bseishen/wordClock/README.md

wordClock
==========

This repository contains my own take on the word clock. Insperation came from an instructable(http://www.instructables.com/id/Sleek-word-clock/). The hardware drives a matrix of 13x8 led's. Uses mosfets for the rows and a TLC5940 for the column driver.
