bseishen/wordClock/CNC/README.md

# Compiling
Run `make` to automatically compile and export all of the src files as stl files.  Make sure to update the path to your openscad installation.
