bseishen/wordClock/CNC/output/ledBoard.stl

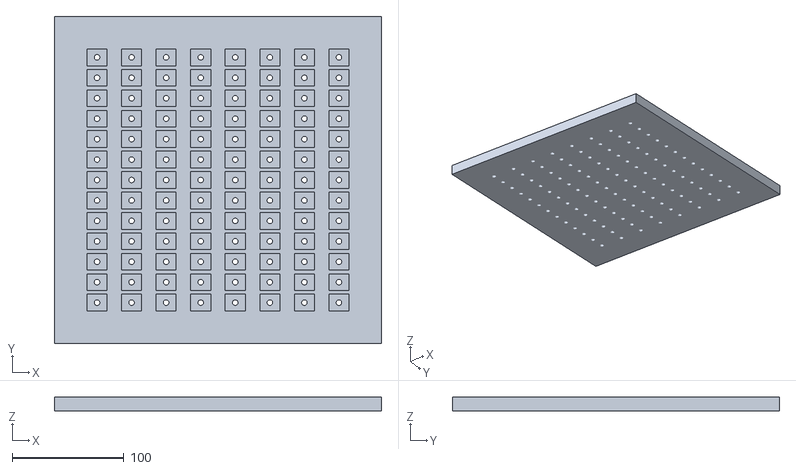
[picture p1: CAD file, 2013-11-08]
CNC/output/ledBoard.stl
292.1 x 292.1 x 12.7
