bseishen/wordClock/CNC/src/ouputDXF.dxf

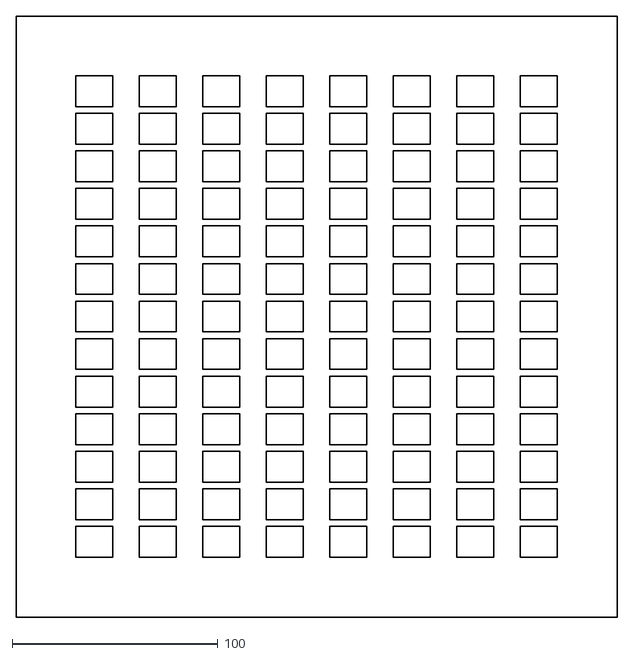
[picture p2: CAD file, 2013-11-08]
CNC/src/ouputDXF.dxf
292.1 x 292.1
