bseishen/wordClock/CNC/configuration.scad

/*
	Authors: Ben Eishen (bseishen)
			  Kit (slav3_kitten)
			  Daniel Hess (dan9186)
	Git Hub:  https://github.com/bseishen/wordClock
*/

//****** Variables to Adjust ******//
//Board Values
BoardWidth = 292.1;
BoardLength = 292.1;
BoardThickness = 12.7;

//Light Values
LightCols = 8;
LightRows = 13;
LightTrim = 29;

//Light Cavity Values
CavityWidth = 18;
CavityLength = 15;
CavityBottomThickness = 4;

//LED Size
LEDRadius = 2.5;
