bseishen/wordClock/hardware/Word Clock.sch

## KiCad design hardware/Word Clock.sch (2013-11-05, an earlier design)

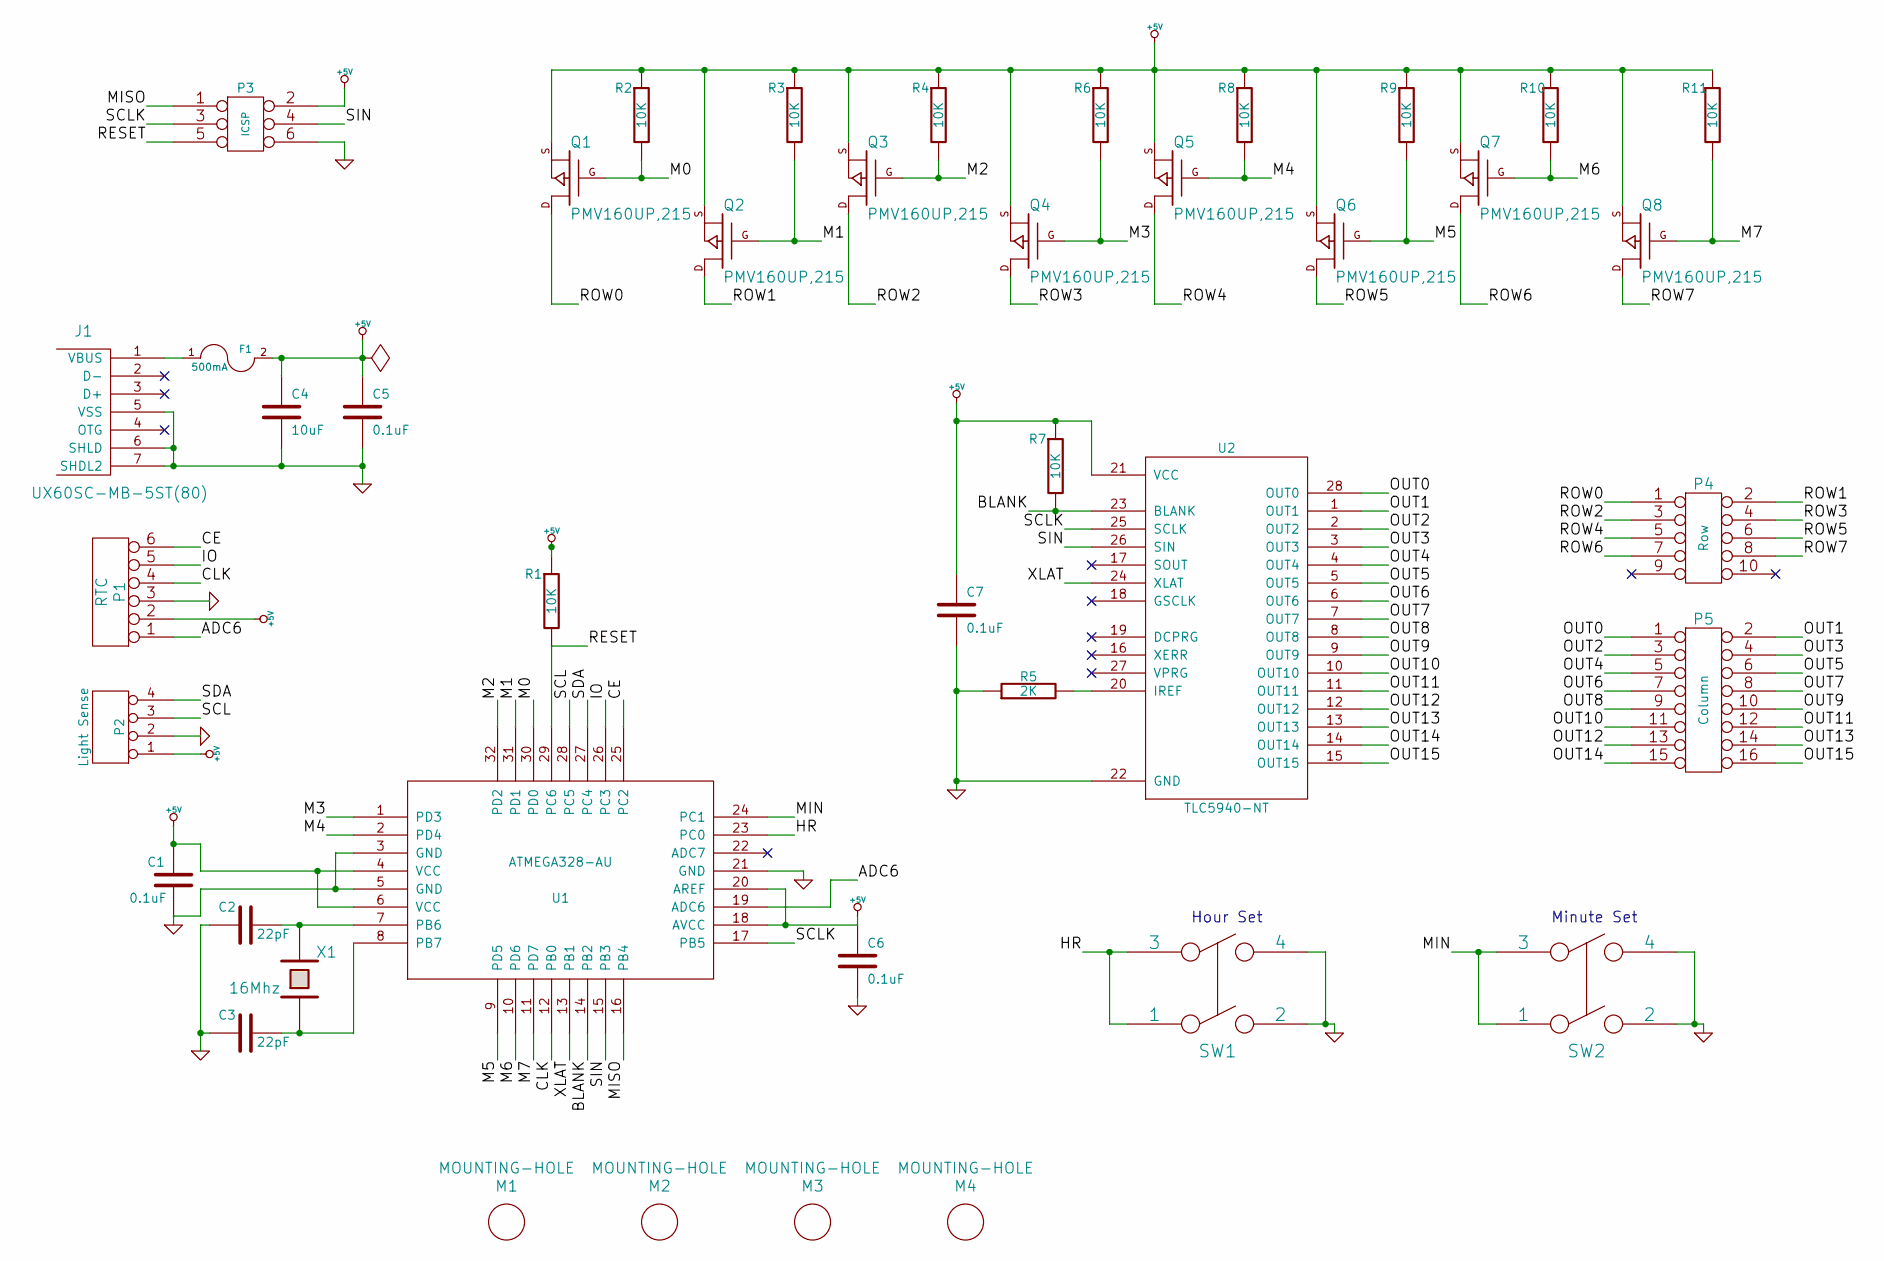
[picture p3: schematic Word Clock.sch]

Parts:
C1, C5, C6, C7: 0.1uF
C2, C3: 22pF
C4: 10uF
F1: 500mA
J1: UX60SC-MB-5ST(80)
M1, M2, M3, M4: MOUNTING-HOLE
P1: RTC
P2: Light Sense
P3: ICSP
P4: Row
P5: Column
Q1, Q2, Q3, Q4, Q5, Q6, Q7, Q8: PMV160UP,215
R1, R2, R3, R4, R6, R7, R8, R9, R10, R11: 10K
R5: 2K
SW1, SW2: DPST
U1: ATMEGA328-AU
U2: TLC5940-NT
X1: 16Mhz

Connections:
+5V: C1.1, C4.1, C5.1, C6.1, C7.1, F1.2, P1.2, P2.1, P3.2, Q1.S, Q2.S, Q3.S, Q4.S, Q5.S, Q6.S, Q7.S, Q8.S, R1.1, R2.1, R3.1, R4.1, R6.1, R7.1, R8.1, R9.1, R10.1, R11.1, U1.4 (VCC), U1.6 (VCC), U1.18 (AVCC), U1.20 (AREF), U2.21 (VCC)
ADC6: P1.1, U1.19 (ADC6)
BLANK: R7.2, U1.14 (PB2), U2.23 (BLANK)
CE: P1.6, U1.25 (PC2)
CLK: P1.4, U1.12 (PB0)
GND: C1.2, C2.1, C3.1, C4.2, C5.2, C6.2, C7.2, J1.5 (VSS), J1.6 (SHLD), J1.7 (SHDL2), P1.3, P2.2, P3.6, R5.1, SW1.2, SW1.4, SW2.2, SW2.4, U1.3 (GND), U1.5 (GND), U1.21 (GND), U2.22 (GND)
HR: SW1.1, SW1.3, U1.23 (PC0)
IO: P1.5, U1.26 (PC3)
M0: Q1.G, R2.2, U1.30 (PD0)
M1: Q2.G, R3.2, U1.31 (PD1)
M2: Q3.G, R4.2, U1.32 (PD2)
M3: Q4.G, R6.2, U1.1 (PD3)
M4: Q5.G, R8.2, U1.2 (PD4)
M5: Q6.G, R9.2, U1.9 (PD5)
M6: Q7.G, R10.2, U1.10 (PD6)
M7: Q8.G, R11.2, U1.11 (PD7)
MIN: SW2.1, SW2.3, U1.24 (PC1)
MISO: P3.1, U1.16 (PB4)
unnamed: C2.2, U1.7 (PB6), X1.2
unnamed: C3.2, U1.8 (PB7), X1.1
unnamed: F1.1, J1.1 (VBUS)
unnamed: R5.2, U2.20 (IREF)
OUT0: P5.1, U2.28 (OUT0)
OUT1: P5.2, U2.1 (OUT1)
OUT2: P5.3, U2.2 (OUT2)
OUT3: P5.4, U2.3 (OUT3)
OUT4: P5.5, U2.4 (OUT4)
OUT5: P5.6, U2.5 (OUT5)
OUT6: P5.7, U2.6 (OUT6)
OUT7: P5.8, U2.7 (OUT7)
OUT8: P5.9, U2.8 (OUT8)
OUT9: P5.10, U2.9 (OUT9)
OUT10: P5.11, U2.10 (OUT10)
OUT11: P5.12, U2.11 (OUT11)
OUT12: P5.13, U2.12 (OUT12)
OUT13: P5.14, U2.13 (OUT13)
OUT14: P5.15, U2.14 (OUT14)
OUT15: P5.16, U2.15 (OUT15)
RESET: P3.5, R1.2, U1.29 (PC6)
ROW0: P4.1, Q1.D
ROW1: P4.2, Q2.D
ROW2: P4.3, Q3.D
ROW3: P4.4, Q4.D
ROW4: P4.5, Q5.D
ROW5: P4.6, Q6.D
ROW6: P4.7, Q7.D
ROW7: P4.8, Q8.D
SCL: P2.3, U1.28 (PC5)
SCLK: P3.3, U1.17 (PB5), U2.25 (SCLK)
SDA: P2.4, U1.27 (PC4)
SIN: P3.4, U1.15 (PB3), U2.26 (SIN)
XLAT: U1.13 (PB1), U2.24 (XLAT)

Notes on the sheet:
Minute Set
Hour Set
