bseishen/wordClock/(threads)

Thread 5 (2013-11-05):

Tolerance between ROW and LIGHT SENSE jacks

bseishen, 2013-11-05:
Tolerances between ROW and LIGHT SENSE jacks are too tight. This is due to the IDC connectors used on ROW and COLUMN. Consider spacing .1" in.

Closed 2023-06-05.
