bseishen/wordClock/(commit log)

2013-10-03 Init commit of wordClock schematic.
    [wordClock.sch]
2013-10-03 added .gitignore, change mosfet layout
    Mosfets now occupy one port, for ease of programming. Mosfet D/S are now
    flipped the right direction.
    [wordClock.sch]
2013-10-03 Added AVR ISP programming header
    [wordClock.sch]
2013-10-03 Fixed Fet to output pinout added pdf schematic
    [wordClock.sch]
2013-10-05 updated SPI program socket, atmega, and usb package names to be a little more meaningful
    [wordClock.sch]
2013-10-05 Added pullup resistors to all P-mosfets
    [wordClock.sch]
2013-10-05 moved hardware related items in to their own subfolder
    [wordClock.sch]
2013-10-06 update changes to atmega component
    [wordClock.sch]
2013-10-06 uploading progress on board layout and routing
    [wordClock.brd]
2013-10-08 Fixed floating nets.
    Looks like the atmega got flipped and some nets were left floating.
    Everything should be connected now.
    [wordClock.sch]
2013-10-08 Fixed ERC errors and Fixed annotation breaks
    Should be all good now, Got broken nets fixed, switched larger usb jack
    for a micro.
    [wordClock.brd, wordClock.sch]
2013-10-09 ALL ANNOTATION BREAKS FIXED
    [wordClock.brd, wordClock.sch]
2013-10-09 Fixed floating nets
    There was a floating net around the crystal, SCL was named SLI on a pin,
    and various ERC errors fixed.
    [wordClock.brd, wordClock.sch]
2013-10-09 Trying my hand at routing the board.
    [wordClock.brd]
2013-10-14 Updated PDF Schematic
2013-11-05 Flushed V1.0, 1.1 is a complete redesign.
    [wordClock.brd, wordClock.sch]
2013-11-05 Version 1.1
    MAJOR BUG, TLC5940NT does't have a GSCLK signal, atmega328 is out of I/O
    pins. New Board Rev. Required.
    [Word Clock.brd, Word Clock.sch]
2013-11-05 Shift Register added to sch
    Since I/O was full on atmega, shift register was added for driving the 8
    mosfets.
    [Word Clock.sch]
2013-11-05 Fixed TLC5940 Missing connections.
    Tied VPRG to GND and DCPRG to VCC.
    [Word Clock.sch]
2013-11-05 Added CNC led board file
    Not finished version.
    [ledBoard.scad, ledBoard.stl]
2013-11-05 Cube issue fix
    changed cube(X,Y,Z) to cube(size = [x,y,z])
    [ledBoard.scad, ledBoard.stl]
2013-11-05 organized models into src and output with an automatic make file to export all of the source files
    [ledBoard.scad, ledBoard.stl]
2013-11-05 improved rendering of LEDBoard by unconstraining the generation of the board and making the spacing of the cavities dynamic based on a desired number of cols and rows
    [configuration.scad, ledBoard.scad]
2013-11-05 updated rendering of stl files from src
    [ledBoard.stl]
2013-11-08 Added DXF output of light boxes and aligned svg
    SVG is now aligned with the lightboxes.
    [configuration.scad, ouputDXF.dxf, ouputDXF.scad]
2013-11-08 Recompiled STL
    [ledBoard.stl]
2013-11-08 Recompiled again.
    [ledBoard.stl]
